eilonyanko/Smart-Greenhouse/docs/README.md

# Documentation

`project-book.pdf` — the full project book. Design and block diagrams, the six circuit
schematics, component notes, measurements, a description of both programs, and the
fault-finding log.

Lightly edited for publication: a signed administrative page was removed and some personal
details were redacted. The technical content is unchanged.
