eilonyanko/Smart-Greenhouse/media/bench-setup.jpg

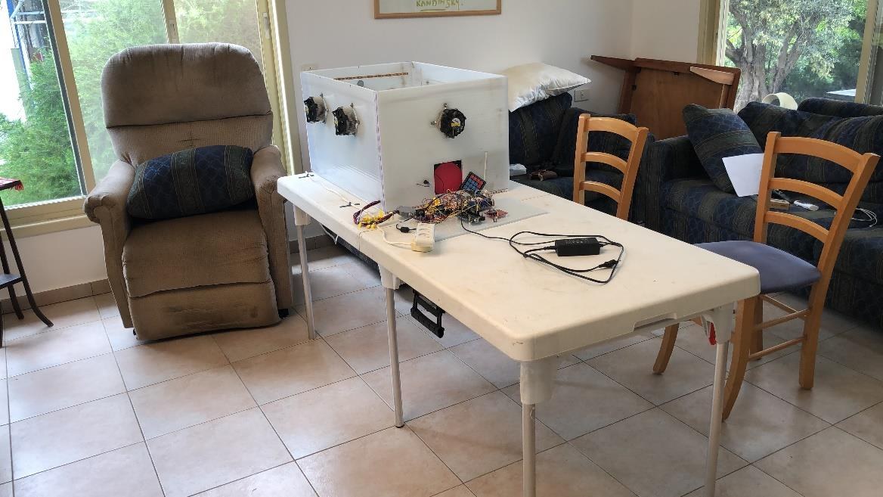
media/bench-setup.jpg
